makers-ie/subspace-sign/hardware/hardware.kicad_pcb

## KiCad design hardware/hardware.kicad_pcb (2017-05-27)

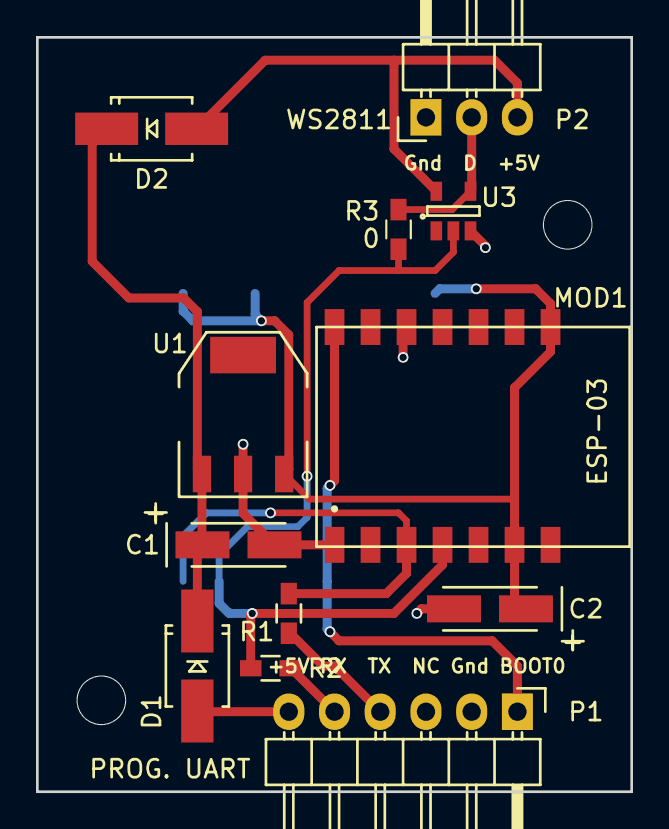
[picture p1: board hardware.kicad_pcb from above]

Board: 2 copper layers, 33.0 x 41.9 mm, 13 parts (1 on the bottom side), 11 nets.

Parts:
C1, C2: CP; TantalC_SizeA_EIA-3216_HandSoldering
D1, D2: D_Schottky; SMA_Handsoldering
MOD1: ESP-03
MOD2: ESP-12F
P1: PROG. UART; Pin_Header_Angled_1x06
P2: WS2811; Pin_Header_Angled_1x03
R1, R2: 100; R_0603_HandSoldering
R3: 0; R_0603_HandSoldering
U1: MCP1754ST-3302E/MB; SOT-223
U3: SN74LV1T34; SOT-23-5

Connections:
+3V3: C2.1, MOD1.6, MOD1.8, MOD2.9, MOD2.11, MOD2.16, U1.3
+5V: C1.1, D1.1, D2.1, U1.1
GND: C1.2, C2.2, MOD1.1, MOD1.12, MOD2.1, MOD2.2, P1.2, P2.1, U1.2, U3.3
unnamed: D1.2, P1.6
unnamed: D2.2, P2.3, U3.5
unnamed: MOD1.3, MOD2.8, R1.1
unnamed: MOD1.4, MOD2.7, R2.1, R3.2, U3.2
unnamed: MOD1.14, MOD2.4, P1.1
unnamed: P1.4, R1.2
unnamed: P1.5, R2.2
unnamed: P2.2, R3.1, U3.4
