makers-ie/subspace-sign/(commit log)

2016-10-11 First version of hardware.
    [hardware.kicad_pcb, hardware.sch]
2016-10-11 Hardware manufacturing files v1.
    [hardware-B.Cu.gbl, hardware-B.Mask.gbs, hardware-B.SilkS.gbo, hardware-Edge.Cuts.gm1, hardware-F.Cu.gtl, hardware-F.Mask.gts, hardware-F.SilkS.gto, hardware.drl]
2016-10-11 Initial version of the ws2811 library.
    This is just a running light with a single pixel running.
    The first LED is static at a bit pattern to test timings.
2016-11-19 Insert final timing component values and fix a missing trace in PCB.
    [hardware.kicad_pcb, hardware.sch]
2016-11-19 Add a UART receiver that reboots on "q\n". Speeds up development.
    [subspace-sign.c]
2017-05-27 Update firmware and hardware to use I2S.
    No need for the multivibrators.
    Need resistor to avoid short with UART TX.
    Added resistor for easier bridging of U3.
    [hardware.kicad_pcb, hardware.sch]
