makers-ie/subspace-sign/(notices)

Notices in the files:
hardware/hardware.kicad_pcb:
© 2016 MAKERS-IE
